candleman28/PID-line-follower-robot/README.md

hello my name is youssef kandil i am a 17 year old egyptian living in kuwait. the american university of the middle east is hosting a ROBOTEX event in kuwait and me and 3 of my friends signed up. our school refused to sponsor us so we bought everything out of our own wallets. my goal is to make back some of the money with the help of hackclub and the forge program.

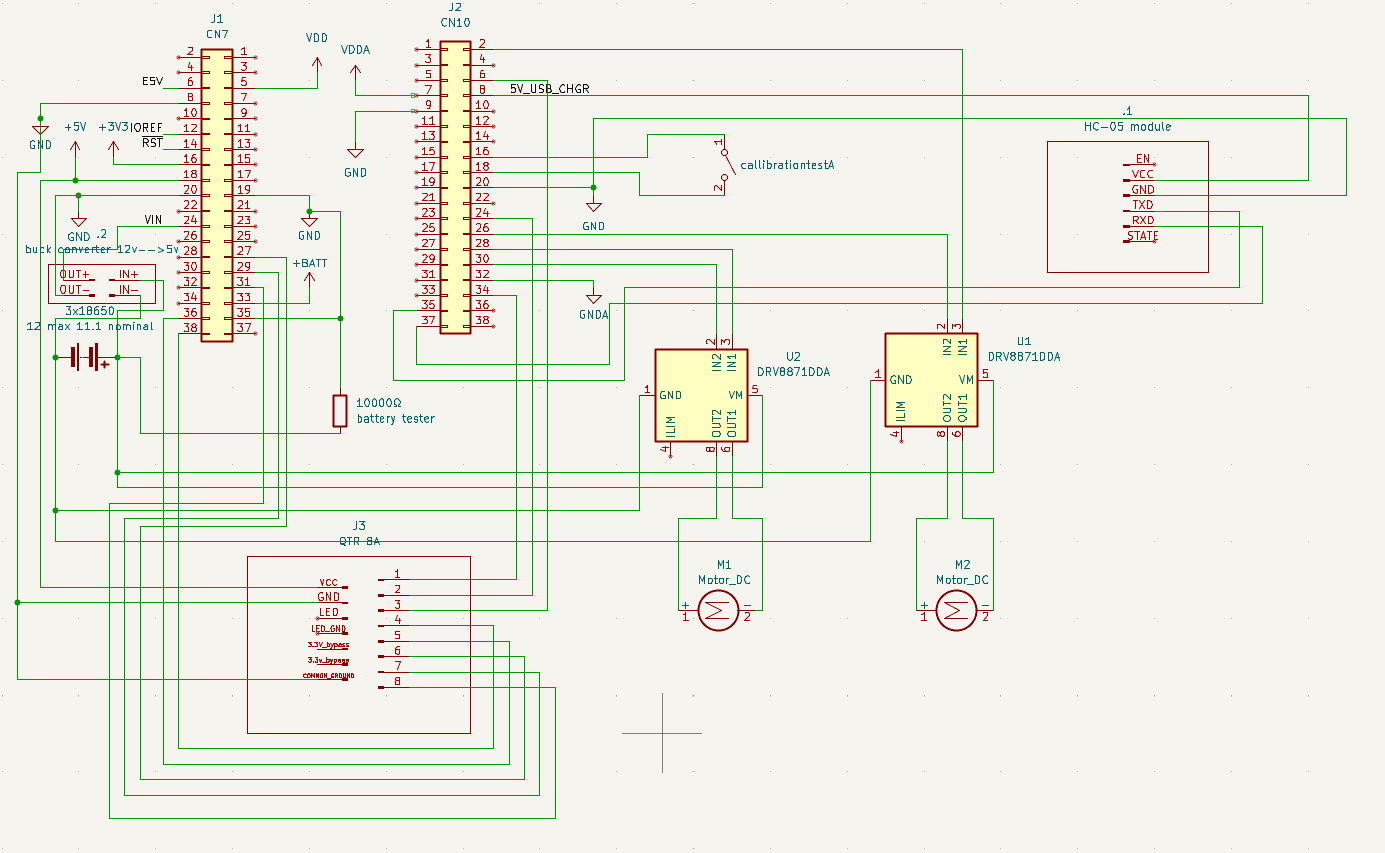
[picture p1: kicad schematic.png]
kicad_schematic

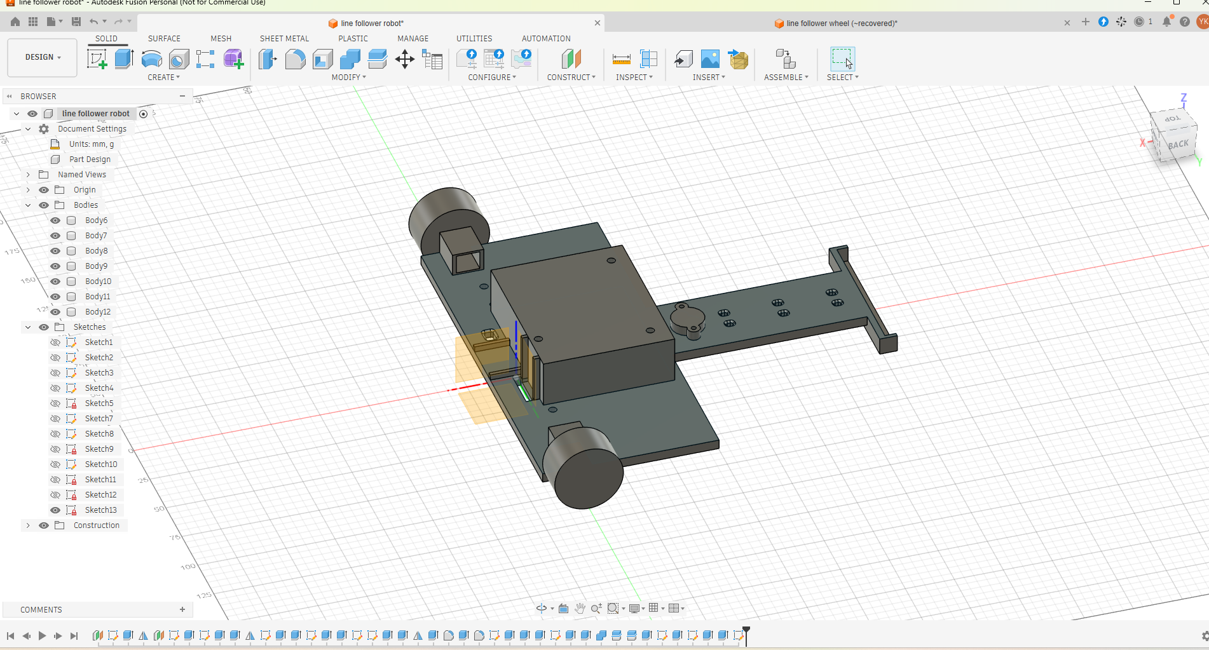
[picture p2: robot body picture.png]
robot_body_picture

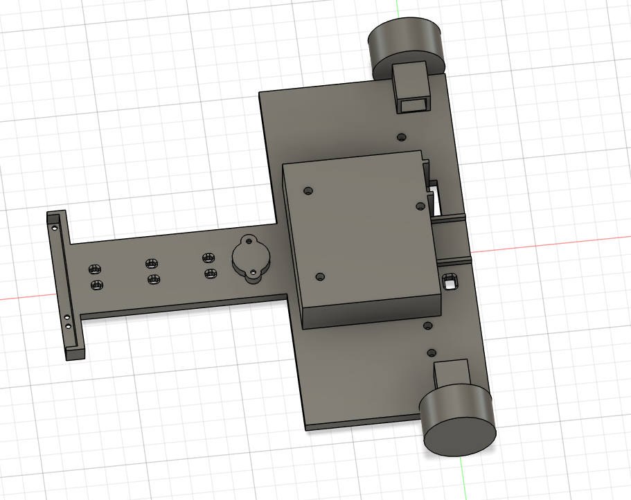
[picture p3: robot body v2.png]
robot_body_v2

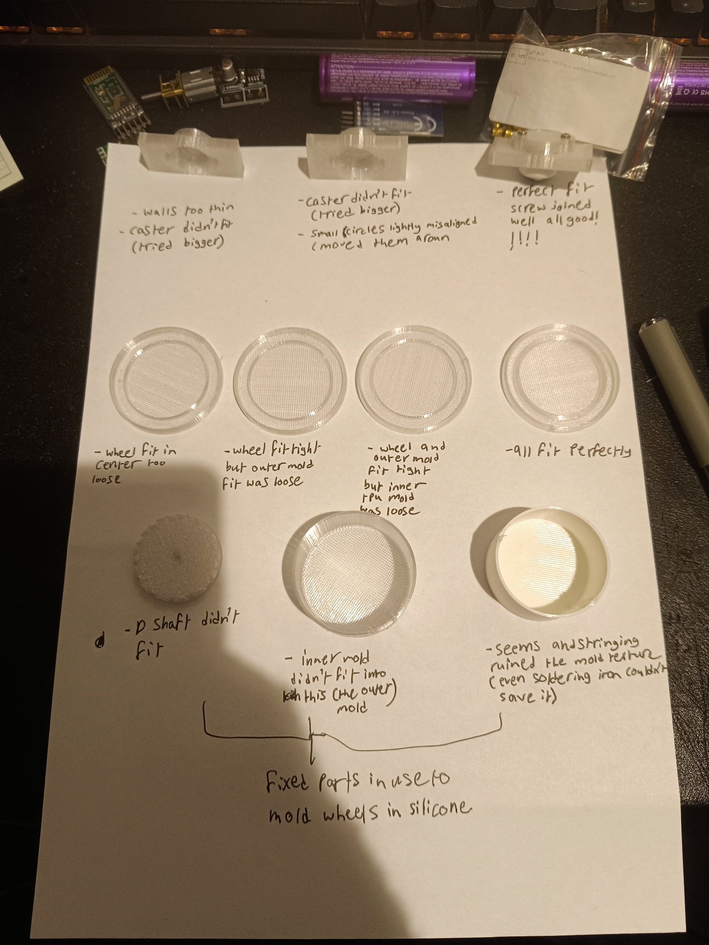
[picture p4: nov 7th iterations.jpg]
iterations


Bill of materials (BOM)
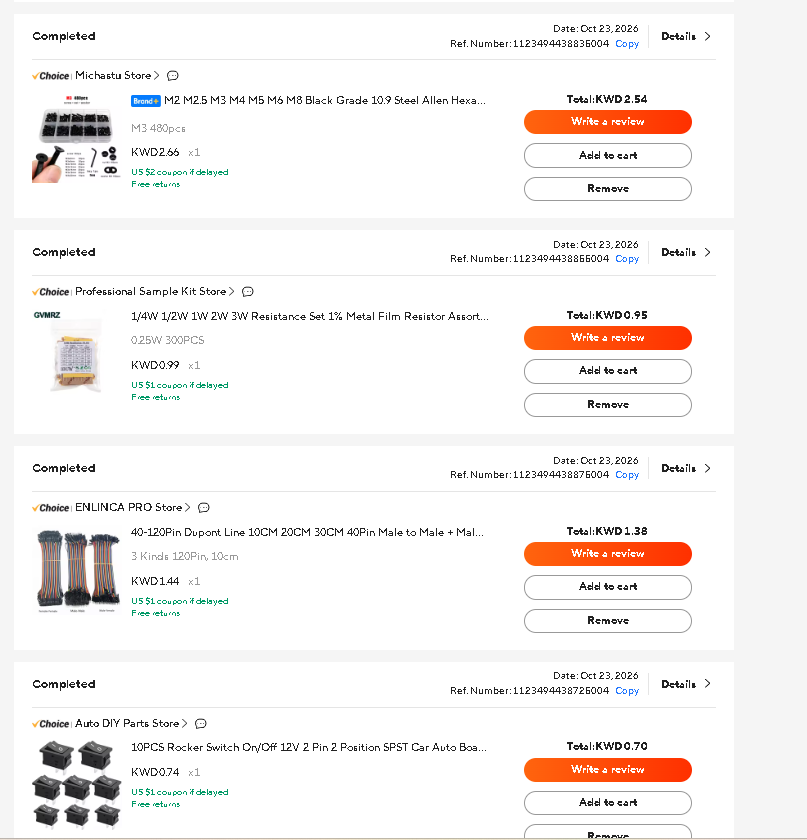
[picture p5: BOM1.png]
BOM1

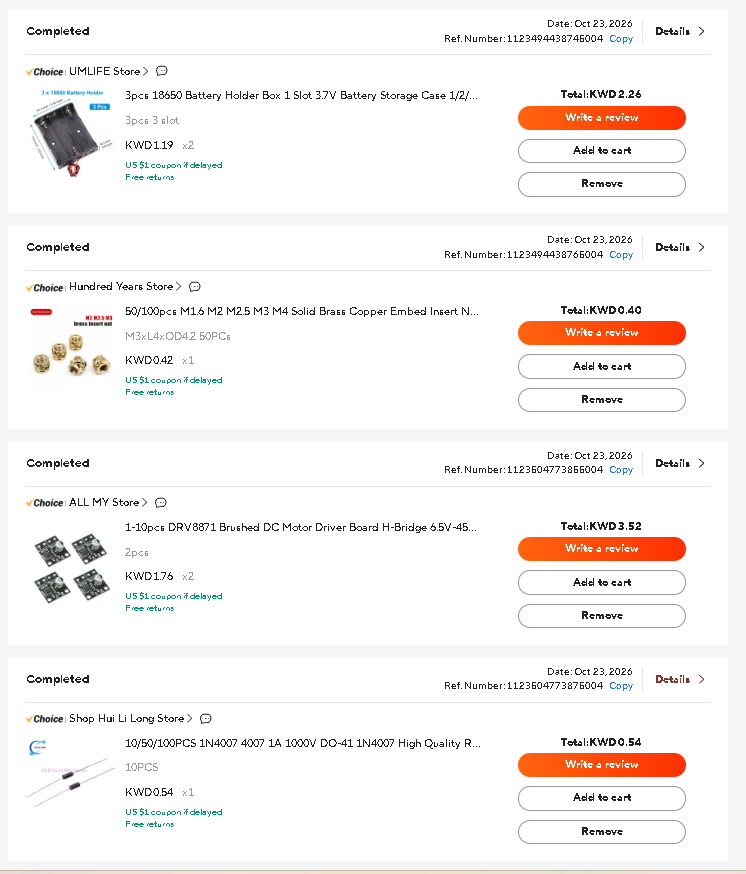
[picture p6: BOM2.png]
BOM2

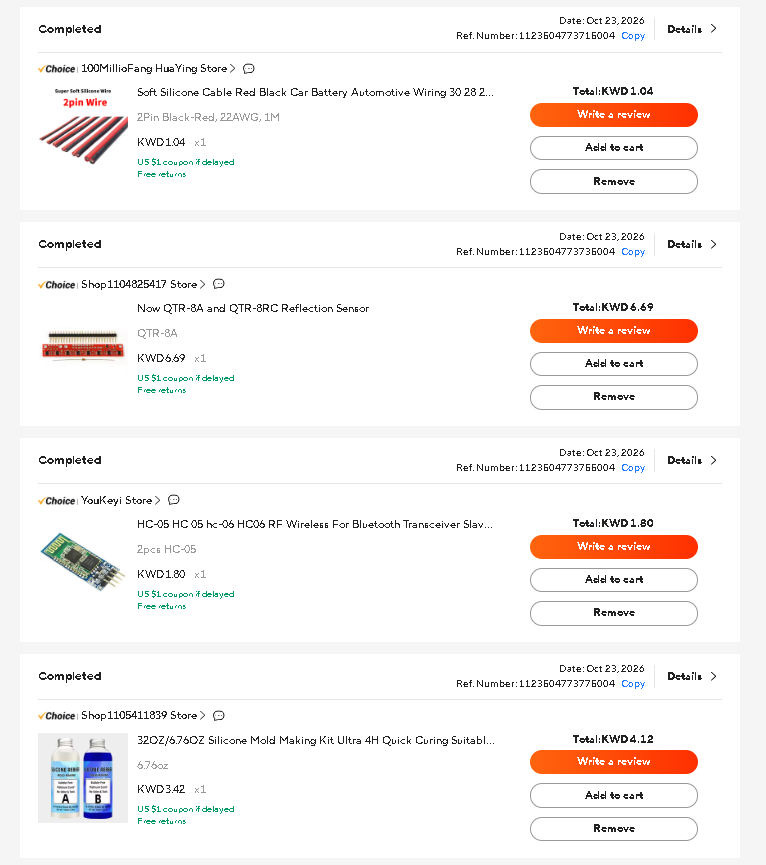
[picture p7: BOM3.png]

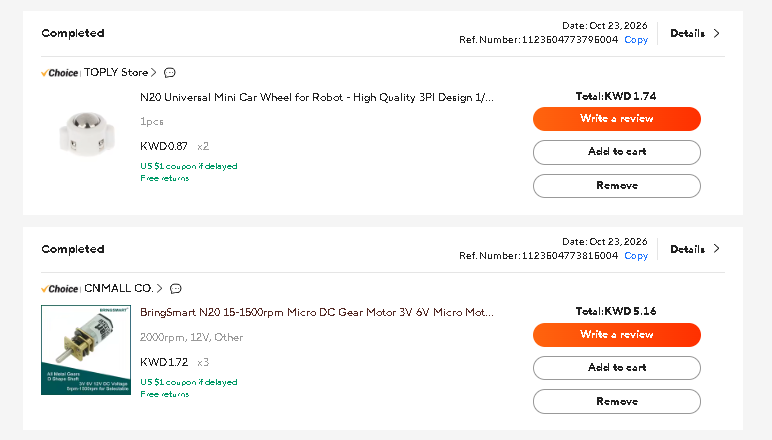
[picture p8: BOM4.png]
