candleman28/PID-line-follower-robot/PETG filament.png

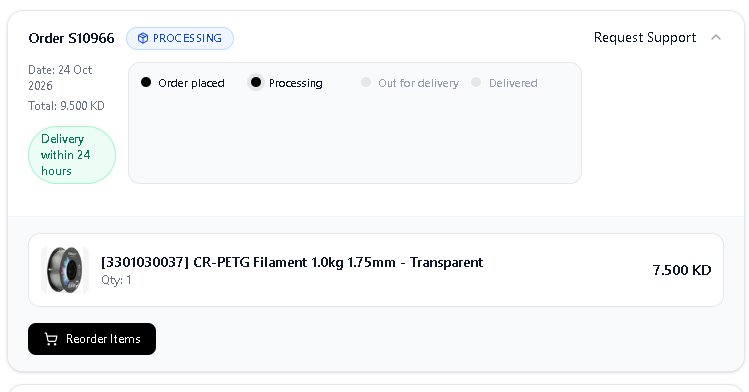
PETG filament.png
