candleman28/PID-line-follower-robot/line follower robot.step

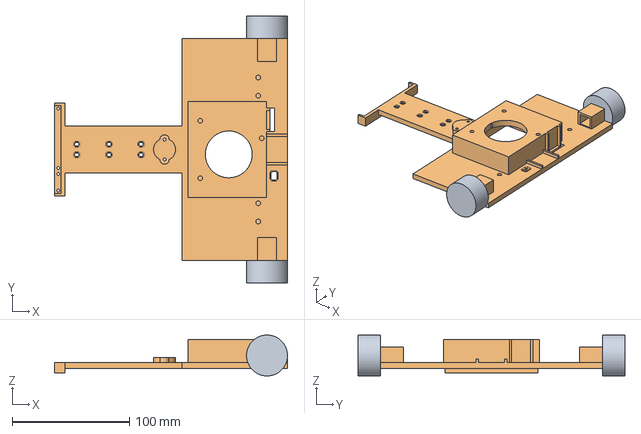
[picture p10: CAD file, 2026-11-08]
line follower robot.step
199.0 x 228.0 x 35.0 mm
