candleman28/PID-line-follower-robot/(list of files, cad)

Other CAD files:
line follower robot.f3d
line follower robot.stl
