candleman28/PID-line-follower-robot/CHANGELOG.md

# Changelog

## 2026-11-08 19:51:04 - line follower robot
- **Branch:** `fusion-export/line_follower_robot-20261108-195104`
- **Commit Message:** "Updated design"
- **Files Updated:**
  - `line follower robot.f3d`
  - `line follower robot.step`
  - `line follower robot.stl`

---
