candleman28/PID-line-follower-robot/(commit log)

2026-11-06 Add files via upload
    schematic for the wiring of the robot. v1
    [line follower robot.kicad_sch]
2026-11-06 Add project journal for PID line follower
    Document progress on PID line follower project with dates and details.
2026-11-06 Update JOURNAL.md with project design details
    Documented the design process for the line follower project, including schematic creation and battery management.
2026-11-08 Revise November 6th journal entry with details
    Updated the journal entry for November 6th to include detailed descriptions of the wheel molding process and tolerance testing results. Adjusted total time spent to reflect 2 hours of work.
2026-11-08 Update November 6th entry with tolerance testing details
    Expanded the entry for November 6th to include details about tolerance and fit testing for the robot body parts, along with updates on the wheel molding process.
2026-11-08 Add Bill of Materials section to README
    Added Bill of Materials (BOM) section with images.
2026-11-08 Updated design
    [line follower robot.f3d, line follower robot.step, line follower robot.stl]
